crtl-destiny/incubator-control-system/文档撰写/元件清单.md

# 生化培养箱控制系统 — 元件清单

## 一、主控与传感器

| 序号 | 名称 | 型号/规格 | 数量 | 单价(元) | 小计(元) | 备注 |
|:----:|:-----|:---|:----:|:---:|:---:|:-----|
| 1 | 核心板 | STM32F103C8T6 最小系统板 | 1 | 15 | 15 | ARM Cortex-M3 72MHz, 64KB Flash, SWD调试 |
| 2 | 温度传感器 | DS18B20 TO-92封装 | 1 | 5 | 5 | 1-Wire数字输出, ±0.5℃精度, -55~125℃ |
| 3 | USB下载线 | Micro USB 数据线 | 1 | 5 | 5 | STM32供电与程序下载 |

## 二、显示与输入

| 序号 | 名称 | 型号/规格 | 数量 | 单价(元) | 小计(元) | 备注 |
|:----:|:-----|:---|:----:|:---:|:---:|:-----|
| 4 | OLED显示屏 | 0.96寸 SSD1306 I2C接口 | 1 | 15 | 15 | 128×64 单色白字, 四针 |
| 5 | 矩阵键盘 | 4×3 薄膜键盘 | 1 | 5 | 5 | 12键: 0~9, *, # |

## 三、驱动与执行

| 序号 | 名称 | 型号/规格 | 数量 | 单价(元) | 小计(元) | 备注 |
|:----:|:-----|:---|:----:|:---:|:---:|:-----|
| 6 | H桥驱动模块 | BTS7960 大电流H桥模块 | 1 | 20 | 20 | 双半桥集成, 最大43A, 6~27V |
| 7 | 加热片 | ST021 聚酰亚胺发热片 | 1 | 10 | 10 | 12V/10W, 尺寸约50×80mm |
| 8 | 半导体制冷片 | TEC1-12706 | 1 | 15 | 15 | 12V/60W, 40×40×3.8mm, 最大温差ΔTmax=68℃ |
| 9 | 散热风扇 | 8015 12V 直流无刷风扇 | 1 | 8 | 8 | 80×80×15mm, TEC热端强制散热 |
| 10 | 散热片 | 铝制鳍片散热片 | 1 | 5 | 5 | TEC热端散热, 尺寸约80×60×20mm |

## 四、通信

| 序号 | 名称 | 型号/规格 | 数量 | 单价(元) | 小计(元) | 备注 |
|:----:|:-----|:---|:----:|:---:|:---:|:-----|
| 11 | USB转TTL模块 | CH340G / CP2102 / FT232 | 1 | 5 | 5 | 3.3V/5V电平可选, STM32串口转USB |

## 五、电源

| 序号 | 名称 | 型号/规格 | 数量 | 单价(元) | 小计(元) | 备注 |
|:----:|:-----|:---|:----:|:---:|:---:|:-----|
| 12 | 开关电源 | 220V AC→12V DC/6A | 1 | 25 | 25 | 金属外壳, 额定功率72W |
| 13 | DC电源接口 | 5.5×2.1mm DC母座 | 1 | 1 | 1 | 开关电源输出接口 |
| 14 | 三端稳压器 | L7805CV TO-220 | 1 | 2 | 2 | 12V→5V, 最大输出1.5A |
| 15 | 低压差稳压器 | AMS1117-3.3 SOT-223 | 1 | 2 | 2 | 5V→3.3V, 最大输出1A |
| 16 | 电解电容 | 470μF/25V | 2 | 1 | 2 | 7805输入/输出滤波 |
| 17 | 电解电容 | 100μF/16V | 2 | 0.5 | 1 | AMS1117输入/输出滤波 |
| 18 | 瓷片电容 | 104 (100nF) | 4 | 0.2 | 0.8 | 各稳压器高频去耦 |

## 六、报警

| 序号 | 名称 | 型号/规格 | 数量 | 单价(元) | 小计(元) | 备注 |
|:----:|:-----|:---|:----:|:---:|:---:|:-----|
| 19 | 有源蜂鸣器 | 5V 有源蜂鸣器 | 1 | 2 | 2 | 内置振荡电路, 低电平触发 |
| 20 | NPN三极管 | S8050 TO-92 | 1 | 0.5 | 0.5 | 蜂鸣器开关驱动 |
| 21 | 电阻 | 1kΩ 1/4W | 1 | 0.1 | 0.1 | 三极管基极限流 |

## 七、电阻与连接

| 序号 | 名称 | 型号/规格 | 数量 | 单价(元) | 小计(元) | 备注 |
|:----:|:-----|:---|:----:|:---:|:---:|:-----|
| 22 | 上拉电阻 | 4.7kΩ 1/4W | 2 | 0.1 | 0.2 | DS18B20 DQ线和I2C SCL/SDA上拉 |
| 23 | 排针 | 2.54mm 单排直针 40P | 1 | 1 | 1 | 各模块接线 |
| 24 | 杜邦线 | 公对公 20cm | 20 | 0.2 | 4 | 各模块互连 |
| 25 | 杜邦线 | 公对母 20cm | 10 | 0.2 | 2 | OLED/键盘等模块连接 |
| 26 | 面包板 | 830孔 面包板 | 1 | 8 | 8 | 原型搭建与调试 |
| 27 | 导线 | 0.5mm² 多芯铜线 1m | 1 | 1 | 1 | 12V电源布线 |
| 28 | 热缩管 | 3mm 热缩管 0.5m | 1 | 1 | 1 | 焊点绝缘保护 |

## 八、总价汇总

| 类别 | 金额(元) |
|:-----|:---:|
| 主控与传感器 | 25 |
| 显示与输入 | 20 |
| 驱动与执行 | 63 |
| 通信 | 5 |
| 电源 | 33.8 |
| 报警 | 2.6 |
| 电阻与连接 | 17.2 |
| **总计** | **≈167** |

> 注：以上价格均为电商平台（淘宝/立创商城）参考价，实际价格可能因购买渠道和批量有所浮动。核心板、BTS7960模块等主要部件建议购买成品模块以降低调试难度。
