crtl-destiny/incubator-control-system/文档撰写/周恭瑾自评互评表.xlsx

Sheet: 基础信息表
计控课设-团队信息表
填表说明：表格杏色底纹部分填写内容，其余不用动。
项目名称：
团队编号 | 团队角色 | 姓名 | 学号 | 班级
0901 | 负责人 |  |  | 自动化2301
指导教师 | 成员1 |  |  | 自动化2301
王艳辉 | 成员2 |  |  | 自动化2301
 | … | … | … | …
指导教师签名 | =DISPIMG("ID_A08B1BBDD01046CB8B5D1E00D71465ED",1)
答辩组签名 | =DISPIMG("ID_1F1695394C5D4F30B6211CC67EB5DEA1",1)
表单签字时间
考核环节 | 过程评分 | 答辩评分 | 团队自评互评 | 成绩评定
签字日期 | 2026-07-08 | 2026-07-09 | 2026-07-09 | 2026-07-10
本工作簿表单用途说明
序号 | 表单名称 | 用途
1 | 基础信息表 | 填写杏色底纹单元格，包括团队编号、指导教师和学生信息，签名采用将图片嵌入单元格的形式。
2 | 过程评分表 | 仅填写评分，即杏色底纹单元格。
3 | 答辩评分表 | 仅填写评分，即杏色底纹单元格。
4 | 团队合作 自评-互评表 | 将学生的打分表评分录入表格中
5 | 成绩评定单 | 自动生成，用于生成PDF文件作为电子存档文件。
6 | 信息汇总表 | 自动生成，仅有复制功能，用于填写负责人提供的成绩、达成度等汇总表格。
最后将表单2、3、4、5生成PDF电子文档用于归档，命名规范如下：
一个团队所有文档统一存放于一个文件夹中。 文件夹命名格式为“团队成绩-团队编号-课设题目-自动化-计控课设2026”，示例如下图所示。 文件夹内仅需存放PDF格式文档，Word版本由指导教师自行留存备用。 文件夹下需包含以下pdf文档，签名部分确保不漏，文档命名规则如下： 1-团队编号-任务书-自动化-计控课设2026 2-团队编号-分工表-自动化-计控课设2026 3-团队编号-会议纪要-自动化-计控课设2026 4-团队编号-课设报告-自动化-计控课设2026 5-团队编号-过程评分表-自动化-计控课设2026 6-团队编号-答辩评分表-自动化-计控课设2026 7-团队编号-自评互评表-自动化-计控课设2026 8-团队编号-成绩评定表-自动化-计控课设2026 9-团队编号-成员贡献表-自动化-计控课设2026

Sheet: 过程评分表
沈阳航空航天大学自动化学院
计算机控制综合课程设计 过程评分表
填报说明：指导教师只需要在杏色评分区域填写权重值1即可。
项目名称： |  | 0
团队角色： |  | 负责人 | 团队编号： |  | 0901
姓 名： |  | 0 | 学 号： |  | 0 |  |  | 班级： |  | 自动化2301
课程 目标 | 评价内容 | 具体要求 |  |  | 权重 | 评分 |  |  |  | 加权分
 |  |  |  |  |  | 5 | 4 | 3 | 2
1 | 问题分析 | 查阅文献、资料，获取有效信息；理解课设任务要求并正确描述，明确制约条件，寻找解决复杂工程问题的方法，并得到有效解。 |  |  | 0.2 |  | 1 |  |  | 0.8
2 | 解决方案 | 能够综合运用专业理论和技术手段设计针对自动控制领域复杂工程问题的解决方案。方案设计自主性良好，理论正确，切实可行。 |  | 目标1 目标2 | 0.4 |  | 1 |  |  | 1.6
3 | 方案设计中综合因素的考虑 | 能够在设计过程中综合考虑社会、健康、安全、法律、文化及环境等因素。 |  | 目标1 目标2 | 0.1 |  | 1 |  |  | 0.4
4 | 团队协作 | 明确个人分工、履行个人职责、对团队成果的贡献。 |  |  | 0.1 | 1 |  |  |  | 0.5
5 |  | 主动沟通、配合团队安排、协调与支持他人、团队责任意识。 |  |  | 0.1 | 1 |  |  |  | 0.5
6 | 项目管理 | 课程设计过程能够综合考虑经济和管理因素，项目进度计划合理，经济可行。 |  | 目标3 | 0.1 |  | 1 |  |  | 0.4
课设过程考核总分(低于3分的学生取消课设答辩资格) |  |  |  |  |  |  |  |  |  | 4.20
 |  |  |  | 指导教师（签字）： |  |  |  | =DISPIMG("ID_A08B1BBDD01046CB8B5D1E00D71465ED",1)
 |  |  |  |  | 2026-07-08
沈阳航空航天大学自动化学院
计算机控制综合课程设计 过程评分表
填报说明：指导教师只需要在杏色评分区域填写权重值1即可。
项目名称： |  | 0
团队角色： |  | 成员1 | 团队编号： |  | 0901
姓 名： |  | 0 | 学 号： |  | 0 |  |  | 班级： |  | 自动化2301
课程 目标 | 评价内容 | 具体要求 |  |  | 权重 | 评分 |  |  |  | 加权分
 |  |  |  |  |  | 5 | 4 | 3 | 2
1 | 问题分析 | 查阅文献、资料，获取有效信息；理解课设任务要求并正确描述，明确制约条件，寻找解决复杂工程问题的方法，并得到有效解。 |  |  | 0.2 |  | 1 |  |  | 0.8
2 | 解决方案 | 能够综合运用专业理论和技术手段设计针对自动控制领域复杂工程问题的解决方案。方案设计自主性良好，理论正确，切实可行。 |  | 目标1 目标2 | 0.4 |  | 1 |  |  | 1.6
3 | 方案设计中综合因素的考虑 | 能够在设计过程中综合考虑社会、健康、安全、法律、文化及环境等因素。 |  | 目标1 目标2 | 0.1 |  | 1 |  |  | 0.4
4 | 团队协作 | 明确个人分工、履行个人职责、对团队成果的贡献。 |  |  | 0.1 | 1 |  |  |  | 0.5
5 |  | 主动沟通、配合团队安排、协调与支持他人、团队责任意识。 |  |  | 0.1 | 1 |  |  |  | 0.5
6 | 项目管理 | 课程设计过程能够综合考虑经济和管理因素，项目进度计划合理，经济可行。 |  | 目标3 | 0.1 |  | 1 |  |  | 0.4
课设过程考核总分(低于3分的学生取消课设答辩资格) |  |  |  |  |  |  |  |  |  | 4.20
 |  |  |  | 指导教师（签字）： |  |  |  | =DISPIMG("ID_A08B1BBDD01046CB8B5D1E00D71465ED",1)
 |  |  |  |  | 2026-07-08
沈阳航空航天大学自动化学院
计算机控制综合课程设计 过程评分表
填表说明：指导教师只需要在杏色评分区域填写权重值1即可。
项目名称： |  | 0
团队角色： |  | 成员2 | 团队编号： |  | 0901
姓 名： |  | 0 | 学 号： |  | 0 |  |  | 班级： |  | 自动化2301
课程 目标 | 评价内容 | 具体要求 |  |  | 权重 | 评分 |  |  |  | 加权分
 |  |  |  |  |  | 5 | 4 | 3 | 2
1 | 问题分析 | 查阅文献、资料，获取有效信息；理解课设任务要求并正确描述，明确制约条件，寻找解决复杂工程问题的方法，并得到有效解。 |  |  | 0.2 |  |  | 1 |  | 0.6
2 | 解决方案 | 能够综合运用专业理论和技术手段设计针对自动控制领域复杂工程问题的解决方案。方案设计自主性良好，理论正确，切实可行。 |  | 目标1 目标2 | 0.4 |  | 1 |  |  | 1.6
3 | 方案设计中综合因素的考虑 | 能够在设计过程中综合考虑社会、健康、安全、法律、文化及环境等因素。 |  | 目标1 目标2 | 0.1 |  | 1 |  |  | 0.4
4 | 团队协作 | 明确个人分工、履行个人职责、对团队成果的贡献。 |  |  | 0.1 |  |  | 1 |  | 0.3
5 |  | 主动沟通、配合团队安排、协调与支持他人、团队责任意识。 |  |  | 0.1 | 1 |  |  |  | 0.5
6 | 项目管理 | 课程设计过程能够综合考虑经济和管理因素，项目进度计划合理，经济可行。 |  | 目标3 | 0.1 |  | 1 |  |  | 0.4
课设过程考核总分(低于3分的学生取消课设答辩资格) |  |  |  |  |  |  |  |  |  | 3.80
 |  |  |  | 指导教师（签字）： |  |  |  | =DISPIMG("ID_A08B1BBDD01046CB8B5D1E00D71465ED",1)
 |  |  |  |  | 2026-07-08

Sheet: 答辩评分表
沈阳航空航天大学自动化学院
计算机控制综合课程设计 答辩评分表
说明：只需在杏色评分区域填写权重1，该表是对整个团队进行评分的。
项目名称 |  | 0
团队编号 |  | 团队角色 | 姓名 | 学号 |  |  |  |  | 班级
0901 |  | 负责人 | 0 | 0 | 自动化2102 |  |  |  | 自动化2301
指导教师 |  | 成员1 | 0 | 0 | 自动化2102 |  |  |  | 自动化2301
王艳辉 |  | 成员2 | 0 | 0 | 自动化2102 |  |  |  | 自动化2301
课程 目标 | 评价内容 | 具体要求 |  | 权重 | 评分 |  |  |  | 加权分
 |  |  |  |  | 5 | 4 | 3 | 2
1 | 问题分析 | 答辩过程中，能够理解课设任务并正确描述，明确任务分工，方案可行。 |  | 0.2 |  | 1 |  |  | 0.8
2 | 解决方案 | 答辩PPT，能够综合运用专业理论和技术手段设计针对自动控制领域复杂工程问题的解决方案。软硬件方案设计良好，理论正确。实验或仿真结果分析正确。 |  | 0.4 |  |  | 1 |  | 1.2
3 | 方案设计中综合因素的考虑 | 能够在设计过程中综合考虑社会、健康、安全、法律、文化及环境等因素。 |  | 0.1 |  | 1 |  |  | 0.4
4 | 团队协作 | 明确个人分工、履行个人职责、对团队成果的贡献 |  | 0.1 |  |  | 1 |  | 0.3
5 |  | 主动沟通、配合团队安排、协调与支持他人、团队责任意识 |  | 0.1 |  | 1 |  |  | 0.4
6 | 项目管理 | 课程设计过程团队整体都能够综合考虑经济和管理因素，项目进度计划合理，经济可行。 |  | 0.1 |  |  | 1 |  | 0.3
总分课设过程答辩总分(低于3分的学生答辩不及格) |  |  |  |  |  |  |  |  | 3.40
答辩组签字： |  | =DISPIMG("ID_1F1695394C5D4F30B6211CC67EB5DEA1",1)
 |  |  |  | 2026-07-09

Sheet: 团队合作自评-互评表
计算机控制综合课程设计 团队合作自评表
团队评分计算方法：所有打分均为百分制，团队评分占课设总成绩权重为20%。 （1）团队负责人得分=负责人自评*40%+（成员对负责人评分累积和/成员人数）*60% （2）成员得分=成员自评*40%+负责人对成员员的评分*60%
团队角色： | 负责人 |  | 团队编号： | 0902
项目名称： | 生化培养箱控制系统设计
姓 名： | 周恭瑾 | 学号： | 233407020330 | 班级： | 自动化2303
自评评分表
评价项目 | 对应教学目标 /毕设指标点 | 评价内容 |  |  | 自评 得分 | 参考 分值
角色认知 | 教学目标4 / 9-1 | 能否清楚认识自己在团队中的角色，明确本人承担的设计、编程、调试、报告或汇报任务。 |  |  | 15 | 15
职责履行 | 教学目标4 / 9-1 | 是否按计划完成本人承担的任务，是否存在拖延、推诿或完成质量不足的问题。 |  |  | 20 | 20
个人贡献 | 教学目标4 / 9-1 | 本人是否对系统设计、程序实现、控制调试、结果分析或报告撰写有实质贡献。 |  |  | 15 | 15
主动沟通 | 教学目标5 / 9-2 | 是否主动与团队成员交流任务进展、技术问题和工作需求。 |  |  | 15 | 15
配合团队安排 | 教学目标5 / 9-2 | 是否能够服从团队整体安排，并根据项目进度调整个人任务。 |  |  | 15 | 15
协调与支持 | 教学目标5 / 9-2 | 是否主动协助其他成员解决问题，促进任务衔接和团队推进。 |  |  | 15 | 15
团队责任意识 | 教学目标5 / 9-2 | 是否关注团队整体目标，维护团队合作氛围和项目完成质量。 |  |  | 5 | 5
合计： |  |  |  |  | 100 | 100
自评分项统计
教学目标 | 对应指标点 | 对应评价项目 |  |  | 得分 | 满分
教学目标4 | 9-1 | 角色认知、职责履行、个人贡献 |  |  | 50 | 50
教学目标5 | 9-2 | 主动沟通、配合团队安排、协调与支持、团队责任意识 |  |  | 50 | 50
 |  |  | 自评日期： |  | 2026-07-09
填表说明：自评得分应为0至对应分值之间的整数；合计和分项统计由表格自动计算。
计算机控制综合课程设计 团队合作自评表
团队评分计算方法：所有打分均为百分制，团队评分占课设总成绩权重为20%。 （1）团队负责人得分=负责人自评*40%+（成员对负责人评分累积和/成员人数）*60% （2）成员得分=成员自评*40%+负责人对成员员的评分*60%
团队角色： | 成员1 |  | 团队编号： | 0901
项目名称： | 0
姓 名： | 0 | 学号： | 0 | 班级： | 自动化2301
自评评分表
评价项目 | 对应教学目标 /毕设指标点 | 评价内容 |  |  | 自评 得分 | 参考 分值
角色认知 | 教学目标4 / 9-1 | 能否清楚认识自己在团队中的角色，明确本人承担的设计、编程、调试、报告或汇报任务。 |  |  |  | 15
职责履行 | 教学目标4 / 9-1 | 是否按计划完成本人承担的任务，是否存在拖延、推诿或完成质量不足的问题。 |  |  |  | 20
个人贡献 | 教学目标4 / 9-1 | 本人是否对系统设计、程序实现、控制调试、结果分析或报告撰写有实质贡献。 |  |  |  | 15
主动沟通 | 教学目标5 / 9-2 | 是否主动与团队成员交流任务进展、技术问题和工作需求。 |  |  |  | 15
配合团队安排 | 教学目标5 / 9-2 | 是否能够服从团队整体安排，并根据项目进度调整个人任务。 |  |  |  | 15
协调与支持 | 教学目标5 / 9-2 | 是否主动协助其他成员解决问题，促进任务衔接和团队推进。 |  |  |  | 15
团队责任意识 | 教学目标5 / 9-2 | 是否关注团队整体目标，维护团队合作氛围和项目完成质量。 |  |  |  | 5
合计： |  |  |  |  | 0 | 100
自评分项统计
教学目标 | 对应指标点 | 对应评价项目 |  |  | 得分 | 满分
教学目标4 | 9-1 | 角色认知、职责履行、个人贡献 |  |  | 0 | 50
教学目标5 | 9-2 | 主动沟通、配合团队安排、协调与支持、团队责任意识 |  |  | 0 | 50
 |  |  | 自评日期： |  | 2026-07-09
填表说明：自评得分应为0至对应分值之间的整数；合计和分项统计由表格自动计算。
计算机控制综合课程设计 团队合作自评表
团队评分计算方法：所有打分均为百分制，团队评分占课设总成绩权重为20%。 （1）团队负责人得分=负责人自评*40%+（成员对负责人评分累积和/成员人数）*60% （2）成员得分=成员自评*40%+负责人对成员员的评分*60%
团队角色： | 成员2 |  | 团队编号： | 0901
项目名称： | 0
姓 名： | 0 | 学号： | 0 | 班级： | 自动化2301
自评评分表
评价项目 | 对应教学目标 /毕设指标点 | 评价内容 |  |  | 自评 得分 | 参考 分值
角色认知 | 教学目标4 / 9-1 | 能否清楚认识自己在团队中的角色，明确本人承担的设计、编程、调试、报告或汇报任务。 |  |  |  | 15
职责履行 | 教学目标4 / 9-1 | 是否按计划完成本人承担的任务，是否存在拖延、推诿或完成质量不足的问题。 |  |  |  | 20
个人贡献 | 教学目标4 / 9-1 | 本人是否对系统设计、程序实现、控制调试、结果分析或报告撰写有实质贡献。 |  |  |  | 15
主动沟通 | 教学目标5 / 9-2 | 是否主动与团队成员交流任务进展、技术问题和工作需求。 |  |  |  | 15
配合团队安排 | 教学目标5 / 9-2 | 是否能够服从团队整体安排，并根据项目进度调整个人任务。 |  |  |  | 15
协调与支持 | 教学目标5 / 9-2 | 是否主动协助其他成员解决问题，促进任务衔接和团队推进。 |  |  |  | 15
团队责任意识 | 教学目标5 / 9-2 | 是否关注团队整体目标，维护团队合作氛围和项目完成质量。 |  |  |  | 5
合计： |  |  |  |  | 0 | 100
自评分项统计
教学目标 | 对应指标点 | 对应评价项目 |  |  | 得分 | 满分
教学目标4 | 9-1 | 角色认知、职责履行、个人贡献 |  |  | 0 | 50
教学目标5 | 9-2 | 主动沟通、配合团队安排、协调与支持、团队责任意识 |  |  | 0 | 50
 |  |  | 自评日期： |  | 2026-07-09
填表说明：自评得分应为0至对应分值之间的整数；合计和分项统计由表格自动计算。
计算机控制综合课程设计 团队合作互评表
团队评分计算方法：所有打分均为百分制，团队评分占课设总成绩权重为20%。 （1）团队负责人得分=负责人自评*40%+（成员对负责人评分累积和/成员人数）*60% （2）成员得分=成员自评*40%+负责人对成员员的评分*60%
项目名称： | 生化培养箱控制系统设计 |  |  | 团队编号： | 0902
评价人 | 团队角色 | 姓名 | 学号 |  | 班级
 | 负责人 | 周恭瑾 | 233407020330 | 自动化2301 | 自动化2303
被评价人 | 成员1 | 张昕铖 | 233407020328 |  | 自动化2303
负责人评价成员 评分表
评价项目 | 对应教学目标 /毕设指标点 | 评价内容 |  |  | 自评 得分 | 参考 分值
角色认知 | 教学目标4 / 9-1 | 能否清楚认识自己在团队中的角色，明确本人承担的设计、编程、调试、报告或汇报任务。 |  |  | 15 | 15
职责履行 | 教学目标4 / 9-1 | 是否按计划完成本人承担的任务，是否存在拖延、推诿或完成质量不足的问题。 |  |  | 20 | 20
个人贡献 | 教学目标4 / 9-1 | 本人是否对系统设计、程序实现、控制调试、结果分析或报告撰写有实质贡献。 |  |  | 15 | 15
主动沟通 | 教学目标5 / 9-2 | 是否主动与团队成员交流任务进展、技术问题和工作需求。 |  |  | 15 | 15
配合团队安排 | 教学目标5 / 9-2 | 是否能够服从团队整体安排，并根据项目进度调整个人任务。 |  |  | 15 | 15
协调与支持 | 教学目标5 / 9-2 | 是否主动协助其他成员解决问题，促进任务衔接和团队推进。 |  |  | 15 | 15
团队责任意识 | 教学目标5 / 9-2 | 是否关注团队整体目标，维护团队合作氛围和项目完成质量。 |  |  | 5 | 5
合计： |  |  |  |  | 100 | 100
互评分项统计
教学目标 | 对应指标点 | 对应评价项目 |  |  | 得分 | 满分
教学目标4 | 9-1 | 角色认知、职责履行、个人贡献 |  |  | 50 | 50
教学目标5 | 9-2 | 主动沟通、配合团队安排、协调与支持、团队责任意识 |  |  | 50 | 50
 |  |  | 互评日期： |  | 2026-07-09
填表说明：互评得分应为0至对应分值之间的整数；合计和分项统计由表格自动计算。
计算机控制综合课程设计 团队合作互评表
团队评分计算方法：所有打分均为百分制，团队评分占课设总成绩权重为20%。 （1）团队负责人得分=负责人自评*40%+（成员对负责人评分累积和/成员人数）*60% （2）成员得分=成员自评*40%+负责人对成员员的评分*60%
项目名称： | 生化培养箱控制系统设计 |  |  | 团队编号： | 0902
评价人 | 团队角色 | 姓名 | 学号 |  | 班级
 | 负责人 | 周恭瑾 | 233407020330 | 0 | 自动化2303
被评价人 | 成员2 | 岳维澳 | 233407020329 |  | 自动化2303
负责人评价成员 评分表
评价项目 | 对应教学目标 /毕设指标点 | 评价内容 |  |  | 自评 得分 | 参考 分值
角色认知 | 教学目标4 / 9-1 | 能否清楚认识自己在团队中的角色，明确本人承担的设计、编程、调试、报告或汇报任务。 |  |  | 15 | 15
职责履行 | 教学目标4 / 9-1 | 是否按计划完成本人承担的任务，是否存在拖延、推诿或完成质量不足的问题。 |  |  | 20 | 20
个人贡献 | 教学目标4 / 9-1 | 本人是否对系统设计、程序实现、控制调试、结果分析或报告撰写有实质贡献。 |  |  | 15 | 15
主动沟通 | 教学目标5 / 9-2 | 是否主动与团队成员交流任务进展、技术问题和工作需求。 |  |  | 15 | 15
配合团队安排 | 教学目标5 / 9-2 | 是否能够服从团队整体安排，并根据项目进度调整个人任务。 |  |  | 15 | 15
协调与支持 | 教学目标5 / 9-2 | 是否主动协助其他成员解决问题，促进任务衔接和团队推进。 |  |  | 15 | 15
团队责任意识 | 教学目标5 / 9-2 | 是否关注团队整体目标，维护团队合作氛围和项目完成质量。 |  |  | 5 | 5
合计： |  |  |  |  | 100 | 100
互评分项统计
教学目标 | 对应指标点 | 对应评价项目 |  |  | 得分 | 满分
教学目标4 | 9-1 | 角色认知、职责履行、个人贡献 |  |  | 50 | 50
教学目标5 | 9-2 | 主动沟通、配合团队安排、协调与支持、团队责任意识 |  |  | 50 | 50
 |  |  | 互评日期： |  | 2026-07-09
填表说明：互评得分应为0至对应分值之间的整数；合计和分项统计由表格自动计算。
计算机控制综合课程设计 团队合作互评表
团队评分计算方法：所有打分均为百分制，团队评分占课设总成绩权重为20%。 （1）团队负责人得分=负责人自评*40%+（成员对负责人评分累积和/成员人数）*60% （2）成员得分=成员自评*40%+负责人对成员员的评分*60%
项目名称： | 0 |  |  | 团队编号： | 0901
评价人 | 团队角色 | 姓名 | 学号 |  | 班级
 | 成员1 | 0 | 0 | 0 | 自动化2301
被评价人 | 负责人 | 0 | 0 |  | 自动化2301
成员评价负责人 评分表
评价项目 | 对应教学目标 /毕设指标点 | 评价内容 |  |  | 自评 得分 | 参考 分值
角色认知 | 教学目标4 / 9-1 | 能否清楚认识自己在团队中的角色，明确本人承担的设计、编程、调试、报告或汇报任务。 |  |  | 15 | 15
职责履行 | 教学目标4 / 9-1 | 是否按计划完成本人承担的任务，是否存在拖延、推诿或完成质量不足的问题。 |  |  | 20 | 20
个人贡献 | 教学目标4 / 9-1 | 本人是否对系统设计、程序实现、控制调试、结果分析或报告撰写有实质贡献。 |  |  | 15 | 15
主动沟通 | 教学目标5 / 9-2 | 是否主动与团队成员交流任务进展、技术问题和工作需求。 |  |  | 15 | 15
配合团队安排 | 教学目标5 / 9-2 | 是否能够服从团队整体安排，并根据项目进度调整个人任务。 |  |  | 15 | 15
协调与支持 | 教学目标5 / 9-2 | 是否主动协助其他成员解决问题，促进任务衔接和团队推进。 |  |  | 15 | 15
团队责任意识 | 教学目标5 / 9-2 | 是否关注团队整体目标，维护团队合作氛围和项目完成质量。 |  |  | 5 | 5
合计： |  |  |  |  | 100 | 100
互评分项统计
教学目标 | 对应指标点 | 对应评价项目 |  |  | 得分 | 满分
教学目标4 | 9-1 | 角色认知、职责履行、个人贡献 |  |  | 50 | 50
教学目标5 | 9-2 | 主动沟通、配合团队安排、协调与支持、团队责任意识 |  |  | 50 | 50
 |  |  | 互评日期： |  | 2026-07-09
填表说明：互评得分应为0至对应分值之间的整数；合计和分项统计由表格自动计算。
计算机控制综合课程设计 团队合作互评表
团队评分计算方法：所有打分均为百分制，团队评分占课设总成绩权重为20%。 （1）团队负责人得分=负责人自评*40%+（成员对负责人评分累积和/成员人数）*60% （2）成员得分=成员自评*40%+负责人对成员员的评分*60%
项目名称： | 0 |  |  | 团队编号： | 0901
评价人 | 团队角色 | 姓名 | 学号 |  | 班级
 | 成员2 | 0 | 0 | 0 | 自动化2301
被评价人 | 负责人 | 0 | 0 |  | 自动化2301
成员评价负责人 评分表
评价项目 | 对应教学目标 /毕设指标点 | 评价内容 |  |  | 自评 得分 | 参考 分值
角色认知 | 教学目标4 / 9-1 | 能否清楚认识自己在团队中的角色，明确本人承担的设计、编程、调试、报告或汇报任务。 |  |  | 15 | 15
职责履行 | 教学目标4 / 9-1 | 是否按计划完成本人承担的任务，是否存在拖延、推诿或完成质量不足的问题。 |  |  | 20 | 20
个人贡献 | 教学目标4 / 9-1 | 本人是否对系统设计、程序实现、控制调试、结果分析或报告撰写有实质贡献。 |  |  | 15 | 15
主动沟通 | 教学目标5 / 9-2 | 是否主动与团队成员交流任务进展、技术问题和工作需求。 |  |  | 15 | 15
配合团队安排 | 教学目标5 / 9-2 | 是否能够服从团队整体安排，并根据项目进度调整个人任务。 |  |  | 15 | 15
协调与支持 | 教学目标5 / 9-2 | 是否主动协助其他成员解决问题，促进任务衔接和团队推进。 |  |  | 15 | 15
团队责任意识 | 教学目标5 / 9-2 | 是否关注团队整体目标，维护团队合作氛围和项目完成质量。 |  |  | 5 | 5
合计 |  |  |  |  | 100 | 100
互评分项统计
教学目标 | 对应指标点 | 对应评价项目 |  |  | 得分 | 满分
教学目标4 | 9-1 | 角色认知、职责履行、个人贡献 |  |  | 50 | 50
教学目标5 | 9-2 | 主动沟通、配合团队安排、协调与支持、团队责任意识 |  |  | 50 | 50
 |  |  | 互评日期： |  | 2026-07-09
填表说明：互评得分应为0至对应分值之间的整数；合计和分项统计由表格自动计算。

Sheet: 成绩评定单
沈阳航空航天大学自动化学院
计算机控制综合课程设计 成绩评定单
项目名称： | 0
团队角色： | 负责人 | 团队编号： |  | 0901
姓 名： | 0 | 学 号： |  | 0 |  |  | 班级： |  | 自动化2301
成绩评定如下：
评价内容 | 具体要求 |  |  |  | 权重 |  | 分值 |  | 加权分值
过程评定 | 详见课程设计过程评分表 |  |  |  | 0.4 |  | 3.8 |  | 1.52
答辩评定 | 详见课程设计答辩评分表 |  |  |  | 0.4 |  | 3.4 |  | 1.36
团队评分 | 详见团队合作自评互评表 |  |  |  | 0.2 |  | 5.0 |  | 1.00
总成绩 |  |  |  |  | 3.88
折合五级制成绩 |  |  |  |  | 中等
课程教学目标得分汇总
课程目标 | 1 | 2 | 3 | 4 |  | 5 |  | 6
目标分值 | 1.0 | 2.0 | 0.5 | 0.5 |  | 0.5 |  | 0.5
得分 | 0.800 | 1.400 | 0.400 | 0.450 |  | 0.475 |  | 0.350
评语：
经过程、答辩和团队综合评定，该同学课设完成情况达到了课设任务书要求，其答辩和课设论文也达到了专业课设论文的要求，故答辩组一致同意下列的成绩。
课程设计成绩: | 中等
指导教师(签字): | =DISPIMG("ID_A08B1BBDD01046CB8B5D1E00D71465ED",1)
 |  |  |  | 2026-07-10
沈阳航空航天大学自动化学院
计算机控制综合课程设计 成绩评定单
项目名称： | 0
团队角色： | 成员1 | 团队编号： |  | 0901
姓 名： | 0 | 学 号： |  | 0 |  |  | 班级： |  | 自动化2301
成绩评定如下：
评价内容 | 具体要求 |  |  |  | 权重 |  | 分值 |  | 加权分值
过程评定 | 详见课程设计过程评分表 |  |  |  | 0.4 |  | 4.2 |  | 1.68
答辩评定 | 详见课程设计答辩评分表 |  |  |  | 0.4 |  | 3.4 |  | 1.36
团队评分 | 详见团队合作自评互评表 |  |  |  | 0.2 |  | 5.0 |  | 1.00
总成绩 |  |  |  |  | 4.04
折合五级制成绩 |  |  |  |  | 良好
课程教学目标得分汇总
课程目标 | 1 | 2 | 3 | 4 |  | 5 |  | 6
目标分值 | 1.0 | 2.0 | 0.5 | 0.5 |  | 0.5 |  | 0.5
得分 | 0.800 | 1.400 | 0.400 | 0.350 |  | 0.375 |  | 0.350
评语：
经过程、答辩和团队综合评定，该同学课设完成情况达到了课设任务书要求，其答辩和课设论文也达到了专业课设论文的要求，故答辩组一致同意下列的成绩。
课程设计成绩: | 良好
指导教师(签字): | =DISPIMG("ID_A08B1BBDD01046CB8B5D1E00D71465ED",1)
 |  |  |  | 2026-07-10
沈阳航空航天大学自动化学院
计算机控制综合课程设计 成绩评定单
项目名称： | 0
团队角色： | 成员2 | 团队编号： |  | 0901
姓 名： | 0 | 学 号： |  | 0 |  |  | 班级： |  | 自动化2301
成绩评定如下：
评价内容 | 具体要求 |  |  |  | 权重 |  | 分值 |  | 加权分值
过程评定 | 详见课程设计过程评分表 |  |  |  | 0.5 |  | 3.8 |  | 1.90
答辩评定 | 详见课程设计答辩评分表 |  |  |  | 0.3 |  | 3.4 |  | 1.02
团队评分 | 详见团队合作自评互评表 |  |  |  | 0.2 |  | 3.0 |  | 0.60
总成绩 |  |  |  |  | 3.52
折合五级制成绩 |  |  |  |  | 中等
课程教学目标得分汇总
课程目标 | 1 | 2 | 3 | 4 |  | 5 |  | 6
目标分值 | 1.0 | 2.0 | 0.5 | 0.5 |  | 0.5 |  | 0.5
得分 | 0.700 | 1.400 | 0.400 | 0.300 |  | 0.375 |  | 0.350
评语：
经过程、答辩和团队综合评定，该同学课设完成情况达到了课设任务书要求，其答辩和课设论文也达到了专业课设论文的要求，故答辩组一致同意下列的成绩。
课程设计成绩: | 中等
指导教师(签字): | =DISPIMG("ID_A08B1BBDD01046CB8B5D1E00D71465ED",1)
 |  |  |  | 2026-07-10

Sheet: 信息汇总表
填表说明：表格内容是自动生成的，和课程负责人要求提交的表格形式一致。
学号 | 姓名 | 班级 | 指导教师 | 团队编号 | 团队角色 | 成绩 | 目标1 | 目标2 | 目标3 | 目标4 | 目标5 | 目标6 | 项目名称
0 | 0 | 自动化2301 | 王艳辉 | 0901 | 负责人 | 中等 | 0.800 | 1.400 | 0.400 | 0.450 | 0.475 | 0.350 | 0
0 | 0 | 自动化2301 | 王艳辉 | 0901 | 成员1 | 良好 | 0.800 | 1.400 | 0.400 | 0.350 | 0.375 | 0.350 | 0
0 | 0 | 自动化2301 | 王艳辉 | 0901 | 成员2 | 中等 | 0.700 | 1.400 | 0.400 | 0.300 | 0.375 | 0.350 | 0
