crtl-destiny/incubator-control-system/code/temperature_control/Core/Inc/main.h

#define BUZZER_PIN      GPIO_PIN_8    /* 蜂鸣器 PA8, 低电平触发 */
#define BUZZER_PORT     GPIOA
#define TEMP_MIN        5.0f          /* 最低设定温度 */
#define TEMP_MAX        50.0f         /* 最高设定温度 */
#define TEMP_DEFAULT    37.0f         /* 默认目标温度 (人体体温培养) */
#define ALARM_TEMP_HIGH 2.0f          /* 温度偏高阈值 */
#define ALARM_TEMP_LOW  2.0f          /* 温度偏低阈值 */
#define CONTROL_CYCLE_MS    200       /* 控制周期 200ms */
#define USB_REPORT_CYCLE    1000      /* 串口上报周期 1s */
