crtl-destiny/incubator-control-system/(commit log)

2026-07-03 初始项目：STM32F103C8T6 生化培养箱控制系统
    - DS18B20 温度传感器
    - SSD1306 OLED 显示 (Font6x8 + Font8x16)
    - 4×3 矩阵键盘
    - 位置式 PID 控制
    - USART1 串口通信
    - RTC 实时时钟
    - BTS7960 H桥驱动
2026-07-03 修复：按键非阻塞 + 主循环响应优化
    1. key.c: 改为完全非阻塞扫描
    - 去掉 HAL_Delay 消抖和 while(等待释放)
    - 增加同键防重 (last_key 静态变量)
    - 无按键按下时立即返回 KEY_NONE
    2. main.c: Key_Scan() 移至 200ms 循环外
    - 每次主循环迭代都扫一次键盘
    - 不再等待200ms周期, 按键响应延迟从 200ms→~1µs
    [key.c, main.c]
2026-07-03 修复: 键盘无响应 + 按键后立即刷新
    1. key.c: 增加 ~2µs 行信号稳定延迟 + 50ms 时间戳去抖
    2. main.c: 检测到按键后立即 Display_Update(), 不等200ms周期
    [key.c, main.c]
2026-07-03 更新设计说明书: 非阻塞键盘 + 主循环优化
    - 4.3.2 主循环图: Key_Scan 移至 200ms 外, 按键后立刻 OLED 刷新
    - 4.7 OLED 刷新策略: 增加按键触发即时刷新描述
    - 4.8 矩阵键盘: 替换为非阻塞扫描算法 + 设计要点表
2026-07-03 3-stage smart alarm algorithm based on plant transfer function
2026-07-03 Fix DS18B20 read timing and buzzer safety
    [main.c]
2026-07-03 Fix key matrix scan logic and buzzer safety guard
    [key.c, main.c]
2026-07-03 Exam pass: all modules verified except buzzer (still beeping) and PWM (untested)
2026-07-03 Fix buzzer polarity: PA8 drives NPN transistor for 5V active buzzer
    PA8 HIGH (3.3V) -> NPN ON -> buzzer ON => GPIO_PIN_SET
    PA8 LOW (0V) -> NPN OFF -> buzzer OFF => GPIO_PIN_RESET
    All buzzer GPIO writes inverted to match hardware topology.
    [main.c, main.h]
2026-07-03 Revert buzzer polarity: direct drive, LOW=ON, HIGH=OFF
    Revert all NPN assumptions. Buzzer is directly driven by PA8,
    active LOW. The 5V vs 3.3V level issue was resolved at hardware level.
    [main.c, main.h]
2026-07-26 Initial commit: 生化保温箱控制系统
    [周恭瑾自评互评表.xlsx]
